Samarth030312/arduino-temperature-control-lab/ROADMAP.md

# Roadmap

| Next | Why |
|---|---|
| The first rig session: T1 to fit the box, then T2–T8 | every number in this repository is a prediction until then |
| A DS18B20 or thermocouple sensor option | finer and faster than the DHT11: shows how much of the behaviour is the sensor |
| Phase-angle (random-fire) SSR option | smooth power without time-proportioning |
| Relay-feedback autotuning mission | identify the ultimate gain and period on the rig |
