Samarth030312/arduino-temperature-control-lab/docs/SIMULINK.md

# Simulink model

`matlab/models/temperature/temperature_plant.slx`, generated by `build_temperature_simulink`
(so it can be reviewed, diffed and rebuilt). Parameters live in the **model workspace** and are
set by `run_temperature_simulink(cfg)` from the same configuration the app simulates.

## From the app

**OPEN IN SIMULINK** builds the model with the current mission's controller, setpoint, gains
and the physics panel's K, τ, θ and sensor, and opens it. Run it; change blocks freely; rebuild
with the button to get the app's version back.

## From a script

```matlab
setup
c = templab.temperature.defaultConfig();           % the physics panel's defaults
c.mode = 'PI'; c.setpoint = 45; c.Kp = 50; c.Ki = 0.5; c.Tend = 1500;
c.ssr = 'average';                                 % Simulink models the SSR's average power
R = run_temperature_simulink(c);                   % Simulink
S = templab.temperature.simulate(c);               % the same loop in MATLAB
c.T0 = 45; R2 = run_temperature_simulink(c);       % start warmer than the room, in both
```

A rig run is replayed with its own recorded settings and starting temperature, in both, by
`temperature_replay_runs` (the 2026-10-26 runs: [session](../results/reports/temperature/2026-10-26/README.md)).

`matlab/tests/test_simulink_model.m` runs on-off, hysteresis, moving average and P in both and
checks they agree: mean reading within 0.3 °C, heater duty within 3 %, the heating phase within
0.05 °C, also from a start 20 °C above the room. The committed model is saved in R2023b's format,
the oldest release CI tests.

## Blocks

```mermaid
flowchart LR
    SP["setpoint"] --> CTRL{"modeSel"}
    CTRL -->|"1"| ON["on-off"]
    CTRL -->|"2"| HY["Relay block: hysteresis"]
    CTRL -->|"3"| MA["Discrete FIR: moving average, then on-off"]
    CTRL -->|"4"| P["P, clamped 0..255"]
    CTRL -->|"5"| PI["Discrete PID: PI / PID, clamping or none"]
    CTRL -->|"6"| OL["open loop: fixed power"]
    ON & HY & MA & P & PI & OL --> U["u / 255"]
    U --> H["η P_bulb"] --> HB(("heat balance")) --> I["1/C ∫"] --> T["T above room"]
    T --> LOSS["1 / R_th"] --> HB
    T --> DEL["transport delay θ"] --> LAG["DHT lag τs"] --> ZOH["ZOH: a value every 2 s"] --> Q["quantiser 0.1 °C"] --> M["reading"]
    AMB["room temperature step"] --> M
    M --> CTRL
```

The SSR is modelled by its average power; the MATLAB simulation can also model the 490 Hz PWM
against a zero-crossing relay (the flicker), Simulink does not.

For the ENR312 Simulink assignments on temperature, see the [course guide](course/README.md).
