Samarth030312/arduino-temperature-control-lab/data/metadata/temperature/TEMP-R0001_20261026-022328_T1.png

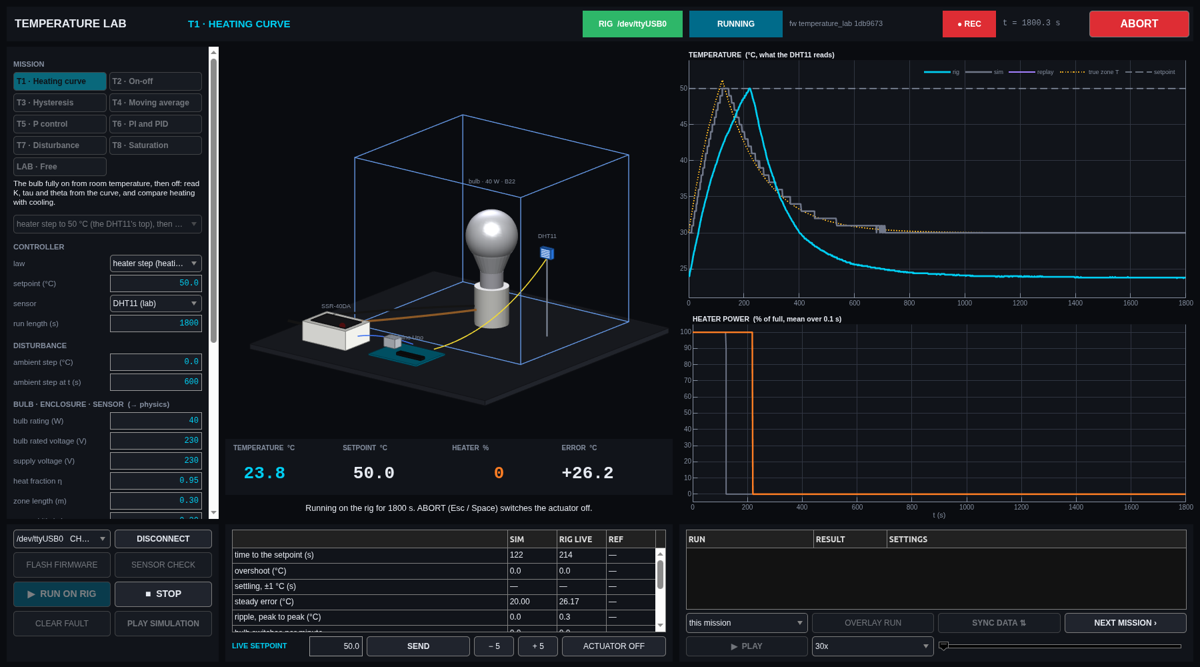
data/metadata/temperature/TEMP-R0001_20261026-022328_T1.png
