Samarth030312/arduino-temperature-control-lab/data/metadata/temperature/TEMP-R0002_20261026-023833_T2.png

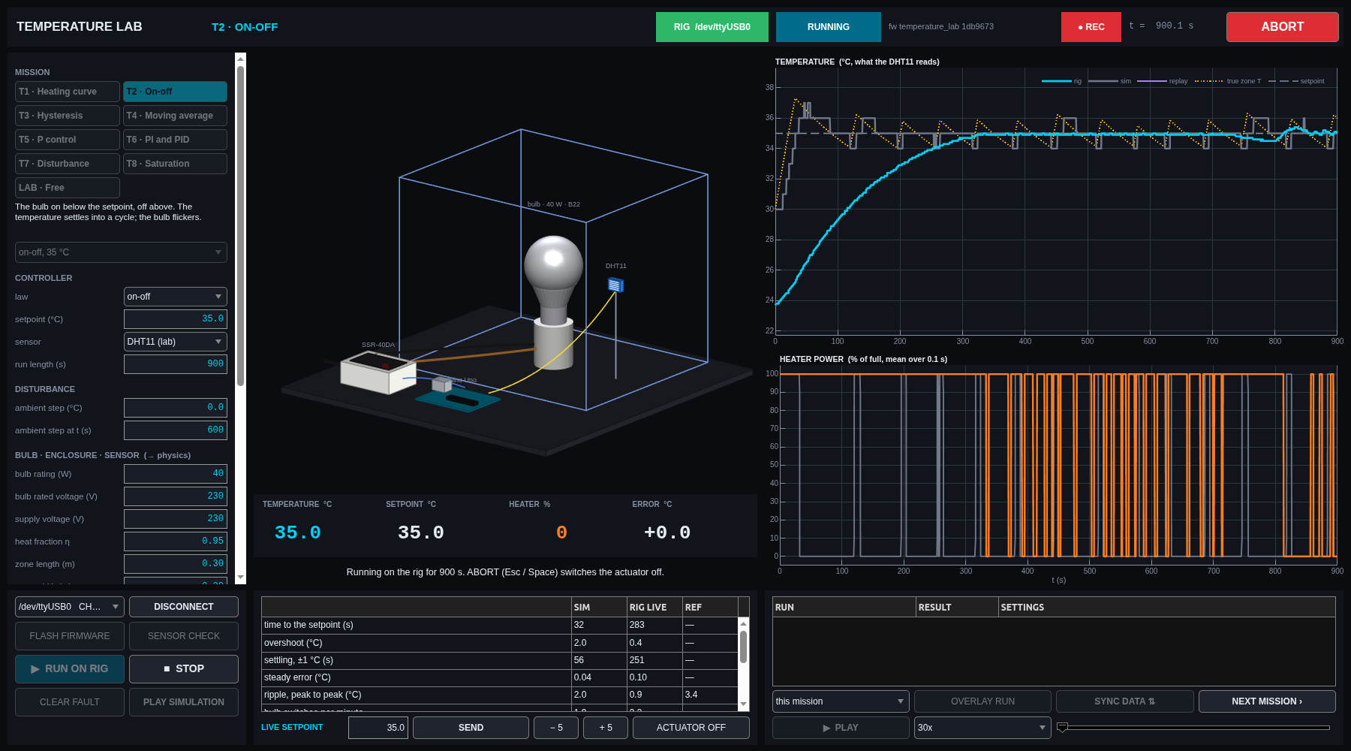
data/metadata/temperature/TEMP-R0002_20261026-023833_T2.png
