Samarth030312/arduino-temperature-control-lab/data/metadata/temperature/TEMP-R0005_20261026-031541_T1.png

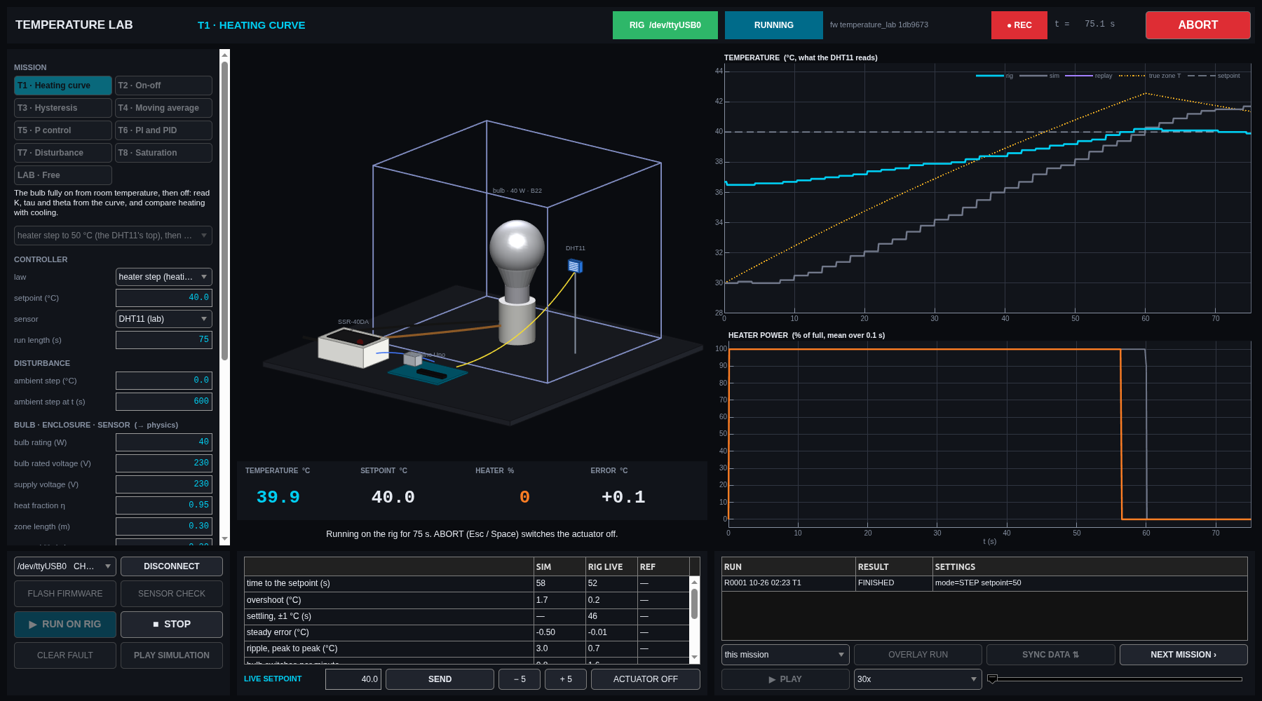
data/metadata/temperature/TEMP-R0005_20261026-031541_T1.png
