Samarth030312/arduino-temperature-control-lab/data/metadata/temperature/TEMP-R0007_20261026-031823_T3.png

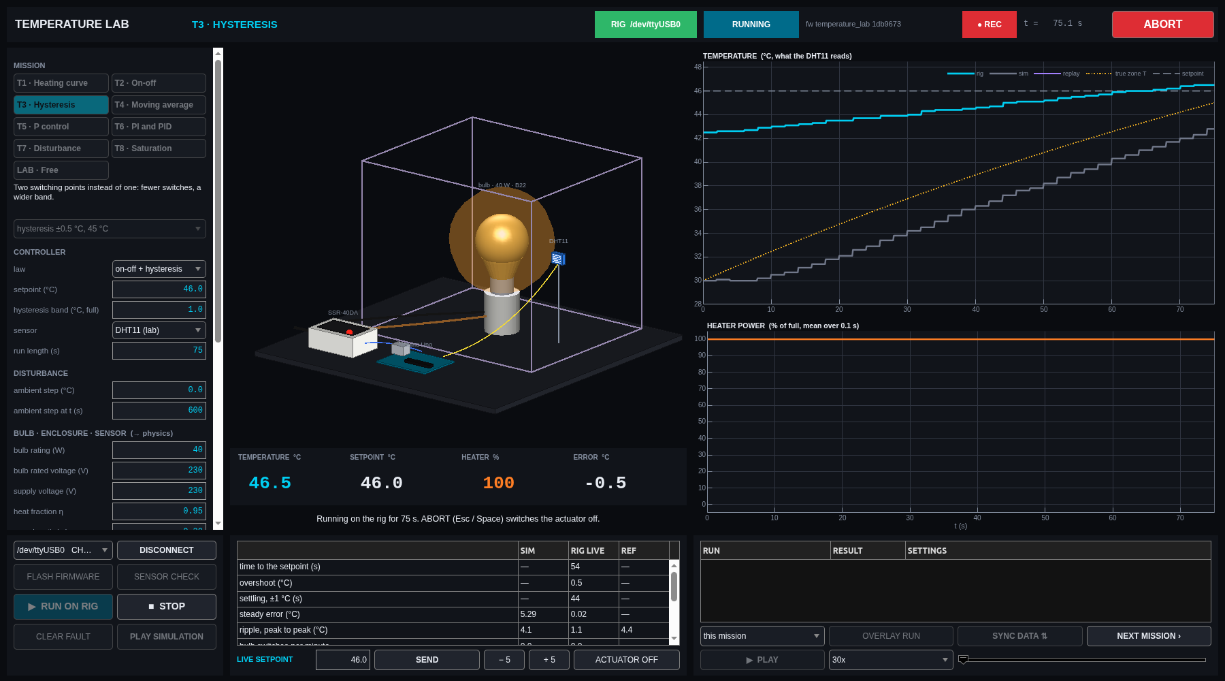
data/metadata/temperature/TEMP-R0007_20261026-031823_T3.png
