Samarth030312/arduino-temperature-control-lab/data/metadata/temperature/TEMP-R0012_20261026-032457_T5.png

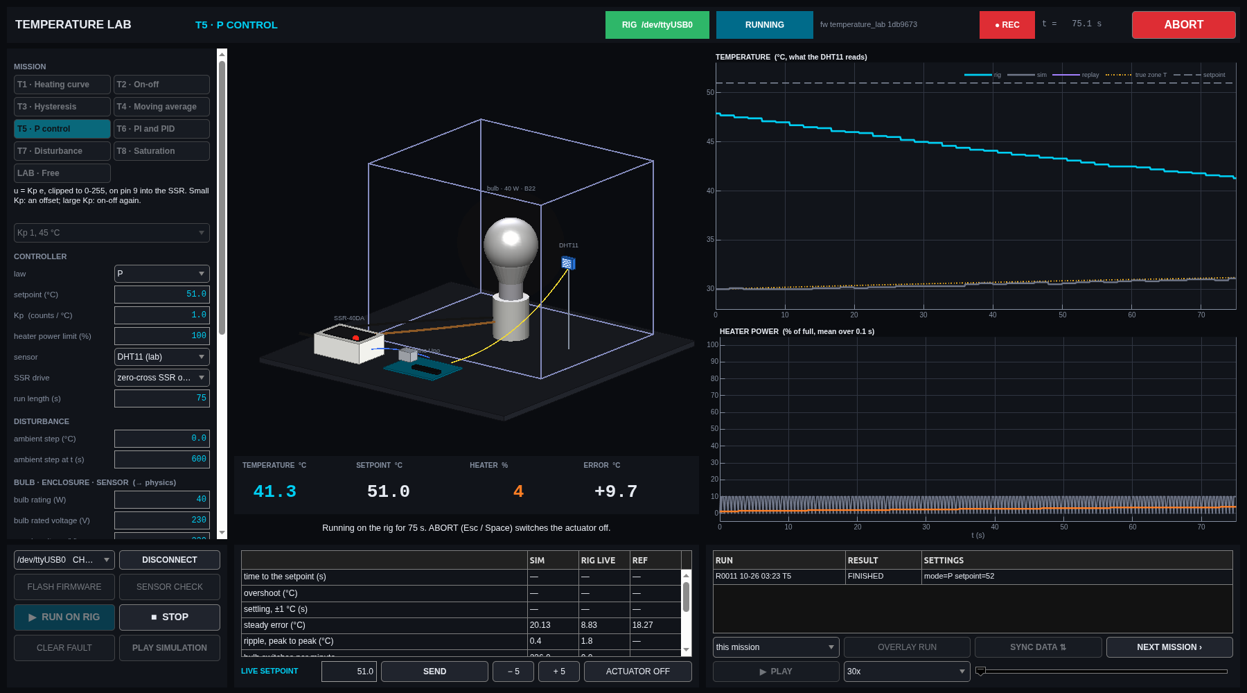
data/metadata/temperature/TEMP-R0012_20261026-032457_T5.png
