Samarth030312/arduino-temperature-control-lab/data/metadata/temperature/TEMP-R0013_20261026-032616_T6.png

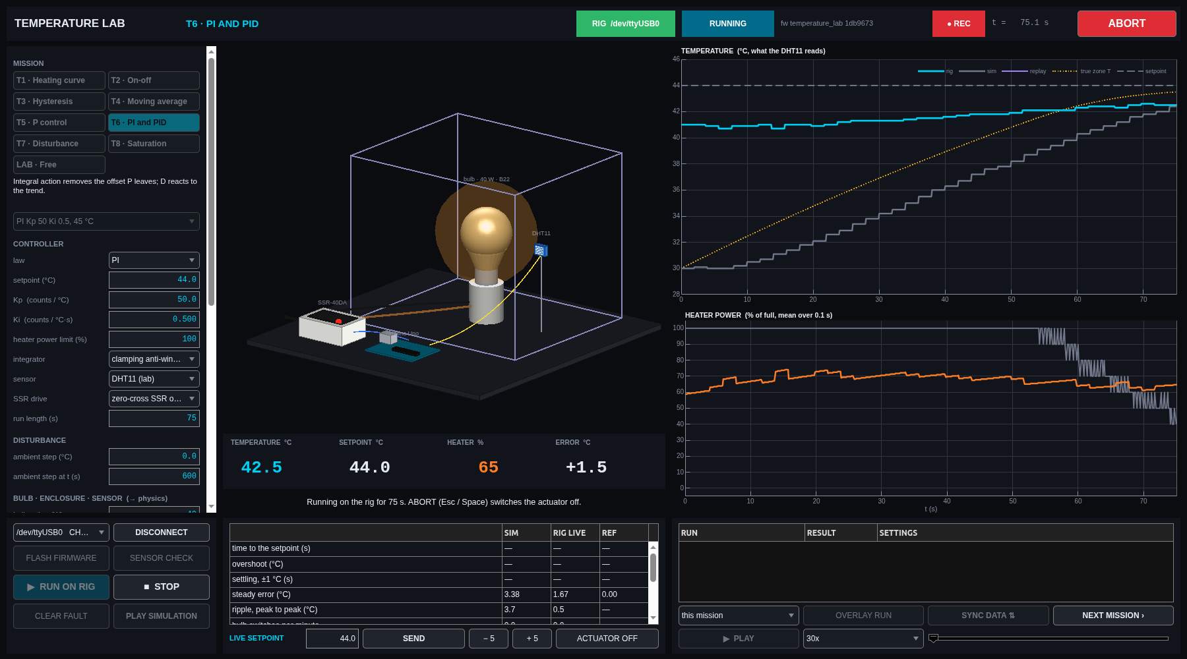
data/metadata/temperature/TEMP-R0013_20261026-032616_T6.png
