Samarth030312/arduino-temperature-control-lab/docs/knowledge-base/SOURCE_REGISTER.csv

source_id | title | source_type | manufacturer_or_author | version_or_date | local_path | url | authority | status | notes
SRC-001 | ENR312 Course File (with page numbers) | Course material | Ahmedabad University SEAS | Monsoon 2025-26; 60 pp; sha256 6ef2fbac...821d | docs/references/downloads/ENR312_CourseFile_Monsoon2025_PageNumbers-1.pdf |  | Course requirements | Reviewed 2026-10-09 | DC motor guideline pp.33-34; report format p.42; Assignment 5 p.14; outline weeks 4-5 and 11 p.8.
SRC-004 | Arduino Uno Rev3 | Hardware documentation | Arduino | Online documentation |  | https://docs.arduino.cc/hardware/uno-rev3/ | Official documentation | To review | Confirm board revision by inspection
SRC-005 | DHT Sensor Library | Software dependency | Adafruit | Installed version to record |  | https://github.com/adafruit/DHT-sensor-library | Upstream source | To install | Temperature experiment
SRC-008 | SSR-40DA Datasheet | Hardware datasheet | Manufacturer to identify | Unknown |  |  | Manufacturer datasheet | Missing | Obtain exact datasheet for the actual relay
SRC-009 | DHT11 / DHT22 Datasheet | Hardware datasheet | Manufacturer to identify | Unknown |  |  | Manufacturer datasheet | To obtain | Bench sensor is DHT11 (owner | 2026-10-21); DHT22 kept as a build option
SRC-010 | Discrete PID Controller block | Software documentation | MathWorks | R2026a |  | https://www.mathworks.com/help/simulink/slref/pidcontroller.html | Official documentation | Referenced | Backward-Euler integrator and filter; clamping anti-windup - matched by pidStep.m
SRC-011 | serialport | Software documentation | MathWorks | R2026a |  | https://www.mathworks.com/help/matlab/ref/serialport.html | Official documentation | Referenced | Used by HardwareLink
SRC-015 | ENR312 Experiment TEMP - guidelines and lab report questions | Course material | Ahmedabad University SEAS | 2026-10 | docs/references/downloads/ENR312_Experiment_TEMP.pdf |  | Course requirements | Reviewed 2026-10-21 | Section 1 tasks; Section 2 questions; Section 3 additional questions (A apparatus / B simulation / C theory). Not redistributed.
