Samarth030312/arduino-temperature-control-lab/docs/guide/img/t1_heating_curve.png

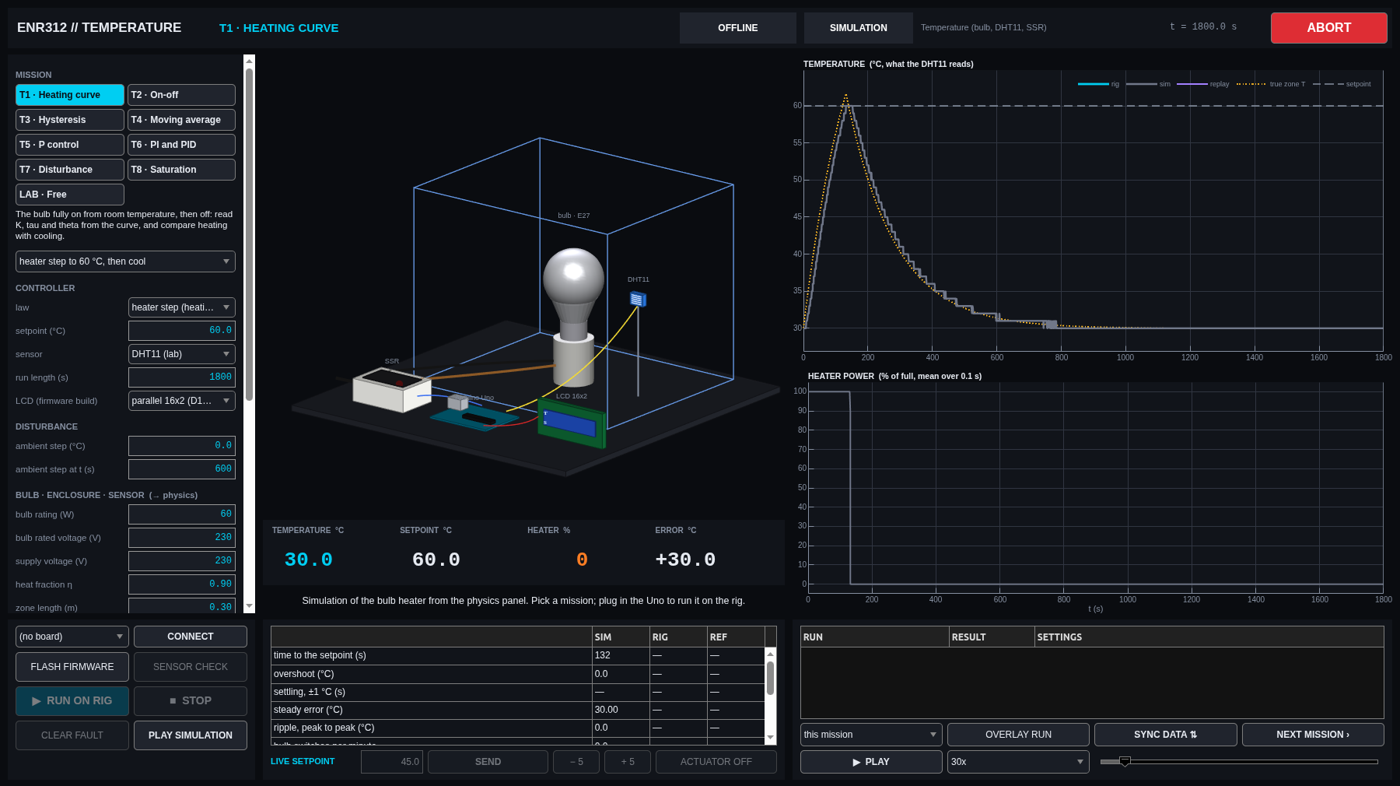
docs/guide/img/t1_heating_curve.png
