Samarth030312/arduino-temperature-control-lab/docs/guide/img/t2_onoff.png

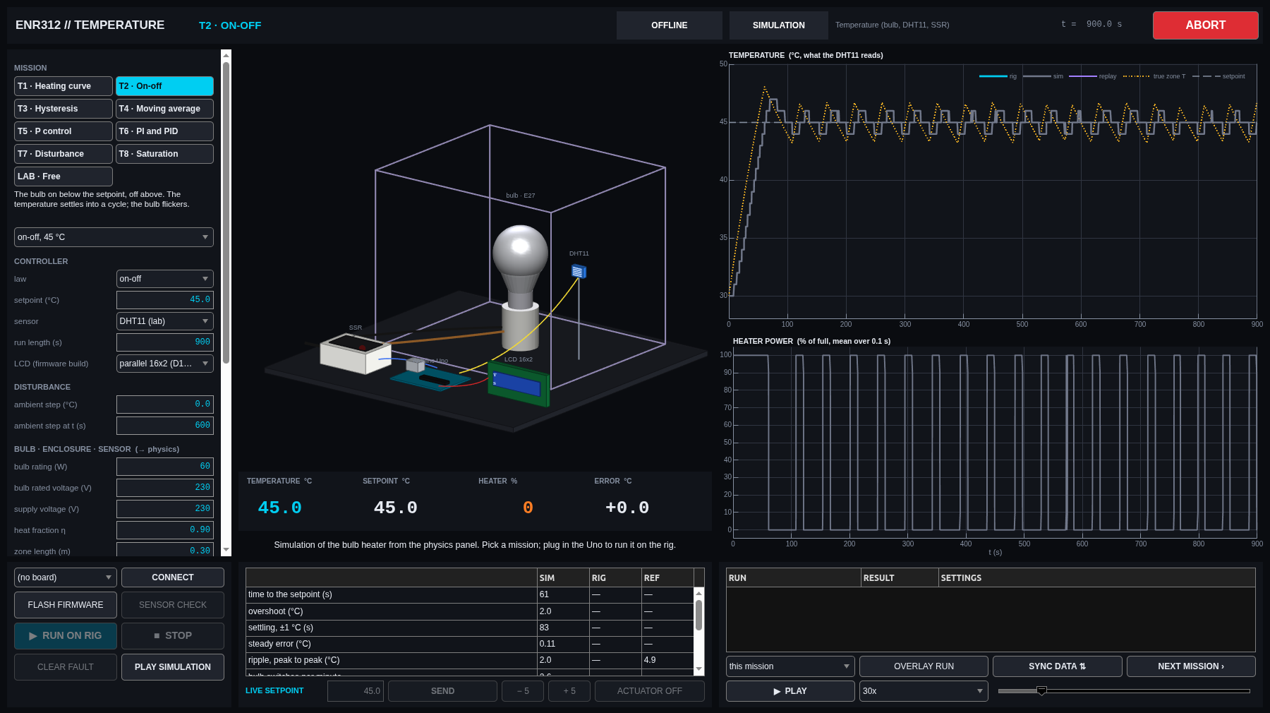
docs/guide/img/t2_onoff.png
