Samarth030312/arduino-temperature-control-lab/results/tables/temperature_replay_2026-10-26_0150.csv

run_id | mode | setpoint_C | T0_C | seconds | rmse_rig_matlab_C | rmse_rig_simulink_C | rmse_matlab_simulink_C | power_rig | power_matlab | power_simulink
TEMP-R0001_20261026-022328_T1 | STEP | 50 | 24 | 1800.6 | 0.87568192750856 | NaN | NaN | 0.121959346884372 | 0.131110123840729 | NaN
TEMP-R0002_20261026-023833_T2 | ONOFF | 35 | 23.7 | 900.3 | 2.34426636819818 | 2.34384274225042 | 0.0169938996313578 | 0.832278129512385 | 0.393258551754776 | 0.393158596179476
TEMP-R0003_20261026-025704_T2 | ONOFF | 45 | 29.9 | 900.2 | 2.63238086449783 | 2.6314620105218 | 0.190013972989163 | 0.988891357476116 | 0.695423747639676 | 0.695323780961902
