Samarth030312/arduino-temperature-control-lab/results/tables/temperature_replay_2026-10-26_0150_on_R0004_plant.csv

run_id | mode | setpoint_C | T0_C | seconds | rmse_rig_matlab_C | rmse_rig_simulink_C | rmse_matlab_simulink_C | power_rig | power_matlab | power_simulink
TEMP-R0002_20261026-023833_T2 | ONOFF | 35 | 23.7 | 900.3 | 1.85827848658074 | 1.8578731843366 | 0.0374103393306853 | 0.832278129512385 | 0.54464682363394 | 0.54464682363394
TEMP-R0003_20261026-025704_T2 | ONOFF | 45 | 29.9 | 900.2 | 1.06800534378457 | 1.06749659911101 | 0.00666592604935972 | 0.988891357476116 | 0.955570365433744 | 0.955570365433744
