Samarth030312/arduino-temperature-control-lab/results/evidence/logs/temp_campaign_20261026-031406.csv

mission | preset | run_id | result | fault | T_start | seconds
T1 | heater step to 50 °C (the DHT11's top), then cool | TEMP-R0005_20261026-031541_T1 | FINISHED |  | 36.7 | 78.773256
T2 | on-off, 35 °C | TEMP-R0006_20261026-031701_T2 | FINISHED |  | 39.8 | 78.460113
T3 | hysteresis ±0.5 °C, 45 °C | TEMP-R0007_20261026-031823_T3 | FINISHED |  | 42.7 | 77.779833
T3 | hysteresis ±2 °C, 45 °C | TEMP-R0008_20261026-031942_T3 | FINISHED |  | 46.6 | 77.940087
T4 | N = 10, 45 °C | TEMP-R0009_20261026-032101_T4 | FINISHED |  | 48.5 | 77.692481
T4 | N = 500, 45 °C | TEMP-R0010_20261026-032219_T4 | FINISHED |  | 49 | 77.603559
T5 | Kp 50, 45 °C | TEMP-R0011_20261026-032338_T5 | FINISHED |  | 49.2 | 77.899478
T5 | Kp 1, 45 °C | TEMP-R0012_20261026-032457_T5 | FINISHED |  | 47.9 | 77.785685
T6 | PI Kp 50 Ki 0.5, 45 °C | TEMP-R0013_20261026-032616_T6 | FINISHED |  | 41.1 | 77.644736
