Samarth030312/arduino-temperature-control-lab/results/tables/temperature_replay_2026-10-26_0314.csv

run_id | mode | setpoint_C | T0_C | seconds | rmse_rig_matlab_C | rmse_rig_simulink_C | rmse_matlab_simulink_C | power_rig | power_matlab | power_simulink
TEMP-R0004_20261026-031220_T2 | ONOFF | 55 | 29.9 | 546 | 0.295670839653235 | 0.294765070668915 | 0.00605227532668811 | 1 | 1 | 1
TEMP-R0005_20261026-031541_T1 | STEP | 40 | 36.7 | 75.2 | 0.601195617260111 | NaN | NaN | 0.75 | 0.79800796812749 | NaN
TEMP-R0006_20261026-031701_T2 | ONOFF | 43 | 39.8 | 75.1 | 0.936918483650874 | 0.936918483650874 | 0 | 0.70306258322237 | 1 | 1
TEMP-R0007_20261026-031823_T3 | HYST | 46 | 42.5 | 75.1 | 1.36445264677804 | 1.36445264677804 | 0 | 1 | 1 | 1
TEMP-R0008_20261026-031942_T3 | HYST | 50 | 46.5 | 75 | 1.25772280994926 | 1.25772280994926 | 0 | 1 | 1 | 1
TEMP-R0009_20261026-032101_T4 | MA | 52 | 48.5 | 75.2 | 0.713472181091516 | 0.713472181091516 | 0 | 1 | 1 | 1
TEMP-R0010_20261026-032219_T4 | MA | 52 | 49 | 75.1 | 0.670015998378066 | 0.670015998378066 | 0 | 1 | 1 | 1
TEMP-R0011_20261026-032338_T5 | P | 52 | 49 | 75.2 | 0.799966754628364 | 0.799966754628364 | 0 | 0.728254067584481 | 0.873476030518447 | 0.873968179569302
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
