Samarth030312/arduino-temperature-control-lab/(commit log)

2026-10-24 Arduino temperature control lab: bulb heater, DHT11, SSR, MATLAB and Simulink
    Firmware with its safety cut-offs, the mission-control app with physics from the parts you
    describe, a Simulink model generated from code, the firmware tested on the PC against an
    emulated rig, one-line set-up for Windows, macOS and Linux, and CI on all three.
    [RUN_REGISTER.csv, SOURCE_REGISTER.csv]
2026-10-24 fix(io): a frame appended by a timer tick while the telemetry table is built no longer breaks it
2026-10-25 feat: the lab's real parts (Philips 40 W bulb, Fotek SSR-40DA, DHT11), no LCD: the DHT11 read every 2 s (datasheet and library), cut-off 60 C so the 55 C set-point runs, T1 heats to 50 C; wiring guid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
2026-10-25 fix: the firmware reports its stops (sensor 5 failed reads in a row, over-temperature) and tolerates single failed DHT reads; the app confirms CFG/SET/RUN/STOP by ACK (bytes are lost while the DHT li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
    [firmware_host_test.cpp, temperature_controller.ino]
2026-10-25 feat: session report, run replay and short campaigns; Simulink starts from a given temperature
    - temperature_session_report: every section from each run's recorded settings, missions
    without runs left out, the plant run and an observation as options, one folder per session
    - temperature_replay_runs: rig runs replayed in the MATLAB simulator and in Simulink
    - temperature_rig_campaign: 'Tend' and 'SpAbove' for short runs
    - simulate and temperature_plant.slx start at c.T0; the DHT lag is a state-space block so it
    can; the model is saved in R2023b's format; test for a warm start
    - params: DHT11 resolution 0.1 C, measured on the rig
    - docs: wiring (measured full-power temperature, sensor-faul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
2026-10-25 data: rig session 2026-10-26, 13 runs (T1-T6), reports and replay tables
    T1: K 31.9 C at full power, tau 138 s, theta 5 s. The rig changed after T1 (OI-T7); the later
    runs are compared with the plant fitted to TEMP-R0004 (K 22.4 C, tau 143 s). MATLAB and
    Simulink agree to 0.04 C or better on every replayed run.
    [RUN_REGISTER.csv, TEMP-R0001_20261026-022328_T1.csv, TEMP-R0002_20261026-023833_T2.csv, TEMP-R0003_20261026-025704_T2.csv, TEMP-R0004_20261026-031220_T2.csv, TEMP-R0005_20261026-031541_T1.csv, TEMP-R0006_20261026-031701_T2.csv, TEMP-R0007_20261026-031823_T3.csv]
